mnorden81/RC-CRSF-Router-RP2350/README.md

# RC-CRSF-Router-RP2350 („CRSF-Router 8“)

CRSF-Verteiler für ELRS-Empfänger auf einem **Waveshare RP2350-Zero**. Der große Bruder des [RC-CRSF-Router-ESP32-S3](https://github.com/mnorden81/RC-CRSF-Router-ESP32-S3): gleiche Weiterleitungsregeln, gleiche Bedienung über das Lua-Menü, aber bis zu 7 statt 2 Ports und **kein WLAN**.

Zwei Versionen, ein Sketch (Auswahl oben in `pins.h`):

| Version | Ports | Pins am RP2350-Zero | Im Sender | Platine |
|---|---|---|---|---|
| **Router** | Eingang + 7 Ports | alle, auch die 5 Pads an der Unterkante | `CRSF-Router8@15` | [hardware/Router](hardware/Router/) |
| **Test** | Eingang + 6 Ports | nur die beiden seitlichen Stiftleisten | `CRSF-Router8 Test@15` | keine, nur für das Steckbrett |

> Stand: Firmware **v0.4.1** („Version 2“: Filter, Telemetrie-Bremse, Geräteliste; dazu gezielte Zustellung und Lua-Vorrang nach ELRS-Vorbild), kompiliert und mit Host-Tests geprüft, **noch nicht auf Hardware getestet**. Erster Hardwaretest am 05.11.2026 auf dem Steckbrett (v0.2.0, nur seitliche Stiftleisten): der Sender findet den Router als „CRSF-Router8@14“ neben dem S3-Router und zwei Sound-Minis. Die Router-Platine ist seit 11.11.2026 fertig geroutet (DRC ohne Fehler), aber noch nicht bestellt.

| Testaufbau | RP2350-Zero auf dem Steckbrett |
|---|---|
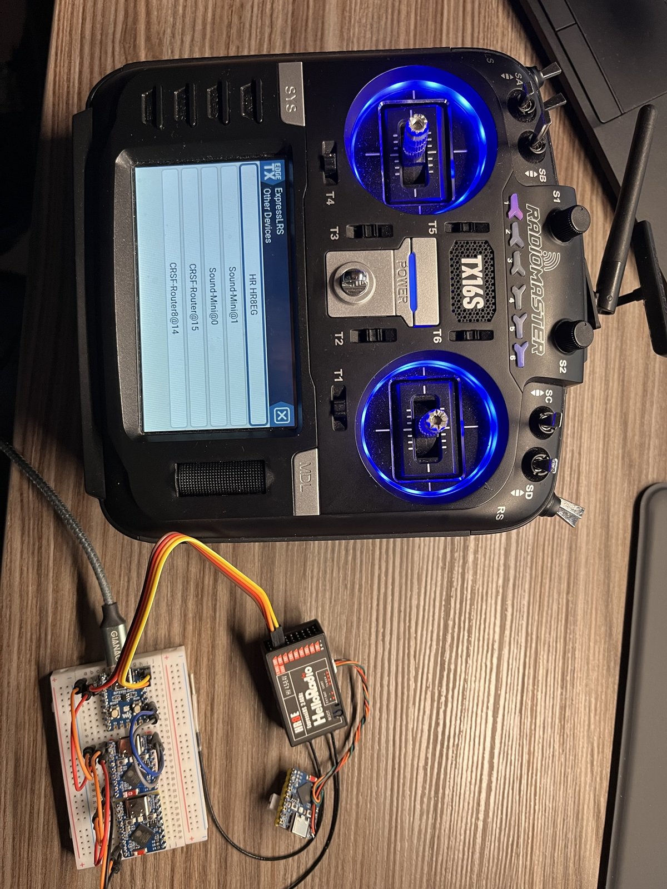
[picture p1: docs/bilder/testaufbau-sender.jpg]
Testaufbau: TX16S zeigt CRSF-Router8@14, CRSF-Router@15 und zwei Sound-Minis
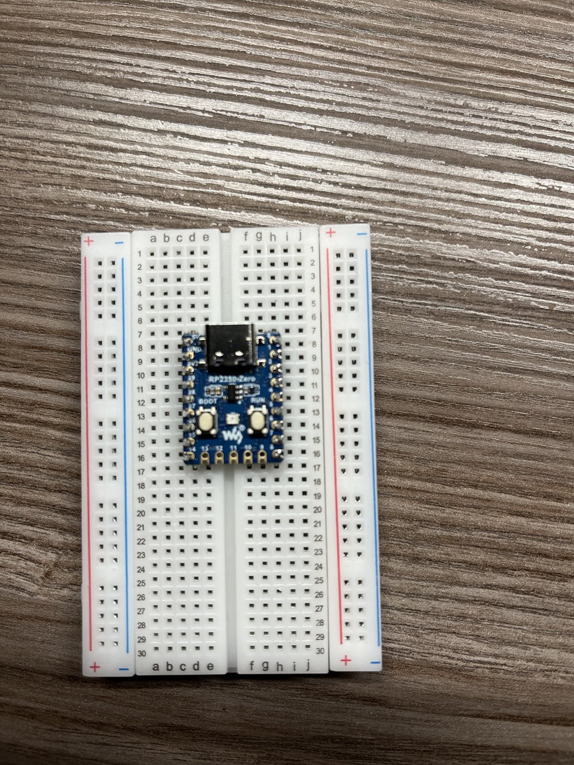
[picture p2: docs/bilder/rp2350-zero-steckbrett.jpg]
RP2350-Zero mit Stiftleisten auf dem Steckbrett
|  |  |

## Was er macht

Der Router hängt an einem freien CRSF-Port des Empfängers und verteilt CRSF auf bis zu 7 Geräte (Test-Version: 6): Multiswitche (auch die Ziege-One-Module), Soundmodule, Sensoren oder weitere Router.

- Vom Empfänger nach unten geht alles, außer Anfragen an die eigene Adresse. Anfragen an ein Gerät, dessen Port der Router schon kennt, gehen nur an diesen Port (ab v0.4.1).
- Von unten nach oben geht alles (Telemetrie, Lua-Antworten, DEVICE_INFO).
- Zwischen den Ports geht nichts, so entstehen keine Schleifen.
- Weitergegeben werden nur vollständige Frames mit gültiger CRC, unverändert.
- Jeder Port hat eine eigene Warteschlange und sendet nicht blockierend. Ein langsamer Port bremst die anderen nicht aus. Wird es eng, fällt zuerst ein alter RC-Frame weg, dann Telemetrie, Lua-Antworten zuletzt.

### Neu in v0.4.0 („Version 2“)

Die Ideen stammen aus dem Vergleich mit dem CRSF-Switch von Wilhelm Meier (wmucpp). Ohne Änderung im Lua-Menü verhält sich der Router genau wie v0.3.0.

| Funktion | Was sie macht | Wirkt |
|---|---|---|
| **Filter je Port** | RC-Kanäle (0x16/0x17) und LinkStats (0x14/0x1C/0x1D) nach unten je Port an oder aus. Ping, Lua und Schaltbefehle gehen immer durch. | sofort |
| **Telemetrie-Bremse je Port** | Telemetrie von unten nach oben: alle, höchstens 50/20/10/5/2/1 Frames pro Sekunde **je Sensor-Art**, oder aus. Bei RPM, Temperatur und Zellen zählt jede Quelle einzeln. DEVICE_INFO und Lua-Antworten gehen immer hoch. | sofort |
| **Geräteliste** | Der Router fragt 2 s und 6 s nach dem Start alle Ports per Ping ab und merkt sich die Antworten (bis 4 Geräte je Port, auch hinter einem weiteren Router). Lua-Ordner „Geräte“ zeigt sie, „Geräte suchen“ fragt neu ab. Antworten auf den eigenen Ping bleiben im Router. Die USB-Konsole listet jede Änderung. | sofort |

### Neu in v0.4.1 (Ideen aus dem ELRS-Empfänger)

Der ELRS-Empfänger hat seit Version 4.0 selbst einen kleinen CRSF-Router (Funkstrecke, CRSF-Port und auf ESP32-Empfängern ein zweiter UART). Drei seiner Regeln hat der Router übernommen. Im Lua-Menü ändert sich nichts, die Einstellungen bleiben erhalten.

| Funktion | Was sie macht |
|---|---|
| **Adress-Lernen + gezielte Zustellung** | Der Router merkt sich, hinter welchem Port welche Adresse sitzt (aus jedem Lua-, Ping- oder Befehls-Frame von unten und aus Heartbeats 0x0B). Lua-Anfragen und Schaltbefehle an ein bekanntes Gerät gehen nur noch an diesen Port. Unbekannte Ziele, Broadcasts (0x00) und 0xC8 gehen weiter an alle. Steckt man ein Gerät um, gilt der Port, von dem es sich zuletzt gemeldet hat. „Geräte suchen“ vergisst alle gelernten Adressen. |
| **Überschreiben statt Verwerfen** | Wartet noch ein Telemetrie-Frame gleicher Art (bei RPM/Temperatur/Zellen gleicher Quelle) vom selben Port, ersetzt der neue ihn an seinem Platz. So geht immer der neueste Wert hoch, die Schlange läuft nicht voll. |
| **Lua-Vorrang nach oben** | Ping-Antworten und Lua-Frames (0x28–0x2D) überholen wartende Telemetrie. Das Lua-Menü bleibt flüssig, auch wenn viele Module Telemetrie schicken. |

Die USB-Konsole zeigt dazu „gezielt“ und „ersetzt“ in der Statuszeile.

Zum Merken: Schaltet man an einem Port die RC-Kanäle ab, sieht ein Gerät dort (auch ein weiterer Router) kein RC-Signal mehr und geht in Failsafe.

## Status-LED (RGB-LED auf dem Board)

| LED | Bedeutung |
|---|---|
| grün langsam | RC-Signal in Ordnung |
| rot schnell | kein RC-Signal / Failsafe |
| gelb Doppelblitz | Adresskonflikt oder ein Port ließ sich nicht starten |

Sind Rot und Grün vertauscht, im Lua-Menü „LED Farbfolge“ auf **RGB** stellen.

## Lua-Menü (ELRS Lua / TBS Agent)

Ab v0.4.0 werden die Feld-IDs fortlaufend vergeben, sie haben sich gegenüber v0.3.0 verschoben (nur wichtig für eigene Skripte). Die Einstellungen aus v0.3.0 übernimmt der Router beim ersten Start.

| Eintrag | Werte |
|---|---|
| Version | z. B. „0.4.1 Router“ |
| Ordner **Ports (nach Neustart)** | |
| ↳ Port 1 … Port 7 | Aus, 57600, 115200, 400000, **420000**, 921600 |
| Ordner **Filter** → je Port ein Ordner | |
| ↳ RC-Kanaele runter | Aus, **Ein** |
| ↳ LinkStats runter | Aus, **Ein** |
| ↳ Telemetrie hoch | **Alle**, 50/s, 20/s, 10/s, 5/s, 2/s, 1/s, Aus |
| Ordner **Geraete** | |
| ↳ Geraete suchen | Nein, Jetzt |
| ↳ Port 1 … Port 7 | Anzeige, z. B. „Multiswitch@3, Sound@2“, „kein Geraet“, „aus“ |
| Modul Adresse | 0–15, Vorgabe **15** |
| Ordner **Telemetrie** | |
| ↳ Spannung senden | **Aus**, als RxBt, als Zellen |
| ↳ Spannung Korrektur | −0,5 … +0,5 V |
| ↳ Spannung | Anzeige |
| ↳ Temperatur senden | **Aus**, Ein |
| ↳ Chiptemperatur | Anzeige |
| Ordner **Status** | |
| ↳ Frames runter / hoch / Verworfen / Gefiltert / CRC-Fehler unten | Zähler |
| ↳ Adresskonflikt | ja/nein |
| ↳ Ports aktiv | je Port: Nummer = Gerät antwortet, `.` still, `-` aus, `!` Fehler |
| LED Farbfolge | **GRB**, RGB |
| Neustart | Nein, Jetzt |
| Geraetename | „CRSF-Router8“ bzw. „CRSF-Router8 Test“ |

Router: 65 Felder, Test: 59 Felder (Port 7 fehlt überall). Im Sender erscheint der Router als **CRSF-Router8@15** bzw. **CRSF-Router8 Test@15** (Name@Adresse).

## Brauche ich den Router überhaupt? (ELRS 4.x)

Ab ELRS 4.0 haben **ESP32-Empfänger** einen zweiten seriellen Port („Serial 2“, im ELRS-Lua oder WebUI auf „CRSF“ stellen; bei PWM-Empfängern lassen sich dafür PWM-Pins umstellen). Der Empfänger verteilt CRSF dann selbst zwischen beiden Ports.

- **Bis zu 2 Module** an einem ESP32-Empfänger: kein Router nötig.
- **Mehr als 2 Module**, **ESP8285-Empfänger** (nur ein CRSF-Port, z. B. EP1/EP2, RP1–RP3) oder Bedarf an Filtern, Telemetrie-Bremse und Geräteliste: Router verwenden.
- Mit Serial 2 kann der Router auch dort hängen, dann bleibt der erste Port für ein anderes Gerät frei.

## Mehrere Router

Jeder Router hat eine eigene WM-Adresse (0–15 → CRSF 0xC0 + Adresse). Mehrere Router im Modell (auch gemischt mit dem S3-Router) bekommen verschiedene Adressen, z. B. 15, 14, 13. Meldet ein Gerät weiter hinten dieselbe Adresse, blinkt die LED gelb. Router lassen sich verketten; mehr als 3 Router hintereinander sind nicht sinnvoll (je ca. 0,6 ms Verzögerung).

## Anschlüsse (Kurzfassung)

| Port | Router TX | Router RX | Test TX | Test RX | Art |
|---|---|---|---|---|---|
| Uplink (Empfänger) | GP0 | GP1 | GP0 | GP1 | Hardware-UART, fest 420000 Baud |
| Port 1 | GP2 | GP3 | GP2 | GP3 | PIO-UART |
| Port 2 | GP4 | GP5 | GP4 | GP5 | Hardware-UART |
| Port 3 | GP6 | GP7 | GP6 | GP7 | PIO-UART |
| Port 4 | GP8 | GP9 | GP8 | GP14 | PIO-UART |
| Port 5 | GP10 | GP11 | GP15 | GP27 | PIO-UART |
| Port 6 | GP12 | GP13 | GP28 | GP29 | PIO-UART |
| Port 7 | GP14 | GP15 | – | – | PIO-UART |
| Spannung | GP26 | | GP26 | | nur mit externem Teiler 33k/10k, auf der Platine nicht vorhanden |

Lage am Board (Oberseite, USB oben): rechte Leiste GP0–GP8, untere Kante GP9–GP13 (nur Lötpads), linke Leiste 5V, GND, 3V3, GP29, GP28, GP27, GP26, GP15, GP14. Die **Router**-Version braucht die Pads unten (5er-Stiftleiste einlöten), die **Test**-Version kommt mit den beiden seitlichen Leisten aus. Mehr als 8 UARTs (2 Hardware + 6 PIO) schafft der RP2350 nicht, deshalb sind 7 Ports das Maximum.

TX des Routers an RX des Geräts und umgekehrt, GND gemeinsam. Details und Schaltplan: [hardware/README.md](hardware/README.md).

## Firmware flashen

Der RP2350 hat kein WLAN, Updates gehen immer über USB. Am einfachsten ist Weg 1, dafür braucht man keine Software.

### Weg 1: Fertige Datei aus GitHub (ohne Arduino IDE)

1. Auf GitHub angemeldet sein (sonst gibt es keinen Download-Knopf).
2. In diesem Repo oben auf **Actions** klicken, links den Workflow **Firmware bauen** wählen.
3. Den obersten Lauf mit grünem Haken öffnen (Branch `main`).
4. Ganz unten unter **Artifacts** **crsf-router8-rp2350-Router** herunterladen (für das Steckbrett: **crsf-router8-rp2350-Test**) und die ZIP-Datei entpacken. Darin liegt `CRSF-Router8_Router.uf2` bzw. `CRSF-Router8_Test.uf2`.
   Steht dort nichts (Artefakte werden nach 90 Tagen gelöscht): rechts oben **Run workflow** → **Run workflow** klicken, nach ca. 3 Minuten ist ein neuer Lauf fertig.
5. Am RP2350-Zero die Taste **BOOT** gedrückt halten und dabei das USB-C-**Datenkabel** einstecken, dann loslassen.
6. Am PC erscheint ein neues Laufwerk **RP2350** (wie ein USB-Stick).
7. Die `.uf2`-Datei mit der Maus auf dieses Laufwerk ziehen. Das Laufwerk verschwindet, der Router startet von selbst neu. Fertig.

### Weg 2: Arduino IDE

**Einmalig einrichten**

1. Arduino IDE 2.x installieren (https://www.arduino.cc/en/software).
2. **Datei → Einstellungen → Zusätzliche Boardverwalter-URLs**:
   `https://github.com/earlephilhower/arduino-pico/releases/download/global/package_rp2040_index.json`
3. **Werkzeuge → Board → Boardverwalter**: „pico“ suchen, **Raspberry Pi Pico/RP2040/RP2350** (von Earle F. Philhower) in Version **6.3.2** installieren.
4. Weitere Bibliotheken sind nicht nötig.

**Flashen**

1. Repo herunterladen: oben auf GitHub **Code → Download ZIP**, entpacken (oder den vorhandenen Ordner nehmen).
2. **Datei → Öffnen** und `firmware/RC_CRSF_Router_RP2350/RC_CRSF_Router_RP2350.ino` wählen.
3. Version wählen: oben in `pins.h` steht `#define VARIANTE_ROUTER` (Vorgabe, für die Platine). Für die Test-Version (Steckbrett) diese Zeile mit `//` auskommentieren und bei `//#define VARIANTE_TEST` die `//` entfernen.
4. **Werkzeuge → Board → Raspberry Pi Pico/RP2040/RP2350 → Waveshare RP2350 Zero** wählen. Die übrigen Einstellungen unter Werkzeuge bleiben auf Standard.
5. Beim **allerersten Mal**: BOOT-Taste gedrückt halten, USB einstecken, loslassen. Unter **Werkzeuge → Port** „UF2 Board“ wählen.
   Ab dem zweiten Mal: einfach einstecken und unter **Werkzeuge → Port** den COM-Port wählen.
6. Auf den Pfeil **Hochladen** klicken. Der Router startet danach von selbst neu.

**Wenn das Hochladen nicht klappt** (kein Port oder „No drive to deploy“): USB abziehen, BOOT gedrückt halten, wieder einstecken und mit Port „UF2 Board“ erneut hochladen.

Der serielle Monitor (115200) zeigt alle 10 s eine Statuszeile.

## Aufbau des Repos

| Ordner | Inhalt |
|---|---|
| `firmware/RC_CRSF_Router_RP2350/` | Arduino-Sketch (siehe [firmware/README.md](firmware/README.md)) |
| `tests/` | Host-Tests des Routers (`sh tests/run_tests.sh`) |
| `hardware/Router/` | KiCad-Projekt der Router-Platine (geroutet, DRC ohne Fehler), nur THT-Bauteile, plus 3D-Modell `hardware/3d-modell.html` (siehe [hardware/README.md](hardware/README.md)) |
| `hardware/gehaeuse/` | 3D-Druck-Gehäuse (STL/STEP, CadQuery-Quelle, 3D-Vorschau), siehe [hardware/gehaeuse/README.md](hardware/gehaeuse/README.md) |
| `docs/` | Projektbeschreibung (DOCX), Fotos unter `docs/bilder/` |

## Herkunft

Die CRSF-Bibliothek stammt aus RC_Common (CRSF_ESP32 1.1.0), Basis ist [CRSF_ESP32 von Ziege-One](https://github.com/Ziege-One/CRSF_ESP32) (GPL-3.0).
