mnorden81/RC-CRSF-Router-RP2350/hardware/3d-modell.html

# CRSF-Router 8, Platine (THT)

Erstes 3D-Modell aus der KiCad-Platzierung, 38,4 × 25,5 mm, alles bedrahtet. Maße und Positionen stammen aus der Platine, die Bauteilkörper sind vereinfacht. Mit den Leiterbahnen der Oberseite (Stand 11.11.2026).

Ziehen = drehen · Rad/Pinch = zoomen · Rechts/zwei Finger = schieben

Ansicht SchrägObenSeite RP2350-Zero zeigen

## Stückliste

Ref | Wert | Bauform

## Aufbau

- Nur THT-Bauteile, von Hand lötbar: Elko 100 µF (Ø 5 mm), liegende Diode und Sicherung bedrahtet.
- Strom nur vom Empfänger über die Reihe U (Pin V), kein eigener BEC-Eingang, keine Spannungsmessung.
- Ohne Spannungsregler: der RP2350-Zero bekommt das BEC über die Diode D1 an seinen 5-V-Pin. Deshalb am Empfänger nur 5 bis 6 V, kein HV-BEC.
- Eine Sicherung (PTC 3 A) für alle Ports statt je Port eine, keine Lötbrücken und keine Serienwiderstände mehr. Übrig sind U1, C1, D1 und F1 statt über 30 Bauteile.
- So kompakt wie möglich: 38,4 × 25,5 mm, keine Befestigungslöcher, Beschriftung auf der Unterseite.
- RP2350-Zero direkt auf die Platine gelötet, ohne Buchsenleisten (Router: auch die 5 Pads unten, GP9–GP13).
