mnorden81/RC-CRSF-Router-RP2350/hardware/gehaeuse/Gehaeuse3D_Vorschau.html

# Gehäuse CRSF-Router 8

Entwurf 1 für die RP2350-Router-Platine (38,4 × 25,5 mm). Unterteil und Deckel zum Aufklipsen, keine Schrauben durch die Platine. Das Steckerfeld ist oben und rechts offen, damit die acht Dupont-Stecker greifbar bleiben. Maße aus der KiCad-Platine vom 11.11.

Außen42,2 × 29,3

Höhe20,3 mm

Platine38,4 × 25,5

Ziehen = drehen · Mausrad/zwei Finger = zoomen · rechte Maustaste = schieben

Zustand Zu Deckel ab Explosion

Ansicht Schräg USB-Seite Stecker-Seite Vorne Oben Unten

Zeigen Platine Stecker Deckel Gehäuse durchsichtig

## Öffnungen

Wo | Wofür | Größe
Links | USB-C zum Flashen, Platz für die Stecker-Umspritzung | 12,6 × 7,2
Rechts + Deckel | Steckerfeld U, 1–7 (8 × 4-pol. Dupont), oben und seitlich offen, Wand bis zur Oberkante der Stiftleisten | 11,4 × 21,2
Deckel | BOOT und RUN: Führungsrohr für Büroklammer oder Zahnstocher | Ø 2,0
Deckel | Lichtrohr über der RGB-LED | Ø 2,6
Deckel | Beschriftung T R V G und U, 1–7 am Steckerfeld | 0,5 tief

## Annahmen, bitte prüfen

- Höhe wird von F1 (PTC MF-RG300) und C1 (Elko 5 × 11) bestimmt. Ich habe F1 mit bis zu 12,5 mm über der Platine angenommen. Sitzt er niedriger oder legst du C1 und F1 flach, kann das Gehäuse um bis zu 7 mm flacher werden (Parameter OBEN).
- BOOT, RUN und LED habe ich aus deinem Steckbrett-Foto geschätzt: 15,3 mm vom USB-Ende, Tasten 4,8 mm links und rechts der Mitte.
- Stecker: 4-polige Dupont-Stecker (2,54 × 10,2 mm) sitzen dicht an dicht. Servo-Stecker (JR/Futaba) passen nur, wenn sie 4-polig sind.
- Halt: Die Platine liegt auf einer 0,8 mm breiten Kante rundum, der Deckel drückt mit vier Niederhaltern an freien Stellen von oben (zwischen Zero und Leisten, Ecken rechts). Keine Schraube, kein Kleben.
- Deckel klemmt mit Lippe und zwei Rastnasen an den Längsseiten. Sitzt er zu stramm, TOL von 0,15 auf 0,2 erhöhen.

## Drucken und Montieren

- Material PLA oder PETG, 0,2 mm Schicht (für die Schrift 0,12 mm).
- Unterteil mit dem Boden aufs Bett, Deckel mit der Oberseite aufs Bett (STL schon gedreht). Keine Stützen nötig.
- Einbauen: Platine mit USB nach links einlegen, Deckel aufdrücken, Stecker von oben aufstecken.
- Im Modell: 2 Laschen mit 2,4-mm-Loch (M2 oder Kabelbinder) oder Klebeband unter den Boden.
- Wand, Boden, Deckel je 1,6 mm.

## Dateien

- Gehaeuse_Unterteil.stl / .step
- Gehaeuse_Deckel.stl / .step
- gehaeuse.py (Quelle, CadQuery, alle Maße als Parameter oben)

Kollisionsprüfung Platine, Bauteile und Stecker gegen Gehäuse: 0 mm³. Autor: PiperPilot.
