mnorden81/RC-CRSF-Router-RP2350/hardware/3d-modell-v2.html

# CRSF-Router 8, Platine Variante 2 (THT)

Erstes 3D-Modell aus der KiCad-Platzierung, 70 × 45 mm, alles bedrahtet. Maße und Positionen stammen aus der Platine, die Bauteilkörper sind vereinfacht. Noch ohne Leiterbahnen.

Ziehen = drehen · Rad/Pinch = zoomen · Rechts/zwei Finger = schieben

Version Router · 7 PortsTest · 6 Ports Ansicht SchrägObenSeite RP2350-Zero gesteckt

## Stückliste dieser Version

Ref | Wert | Bauform

## Was V2 anders macht

- Nur THT-Bauteile, von Hand lötbar: Elko, Kondensator, Widerstände und Dioden bedrahtet.
- Ohne Spannungsregler: der RP2350-Zero bekommt das BEC über die Diode D1 an seinen 5-V-Pin. Deshalb nur BEC mit 5 bis 6 V, kein HV-BEC.
- Eine Sicherung (PTC 3 A) für alle Ports statt je Port eine, keine Lötbrücken und keine Serienwiderstände mehr. Das sind 9 Bauteile statt über 30.
- BEC-Eingang J9 mit Suppressordiode P6KE15CA gegen Spannungsspitzen, Platine 70 × 45 mm mit 4 × M3.
- RP2350-Zero steckt in Buchsenleisten (Router: auch unten 5er-Buchse für GP9–GP13).
