mnorden81/RC-CRSF-Router-RP2350/hardware/gehaeuse/Gehaeuse_Deckel.step

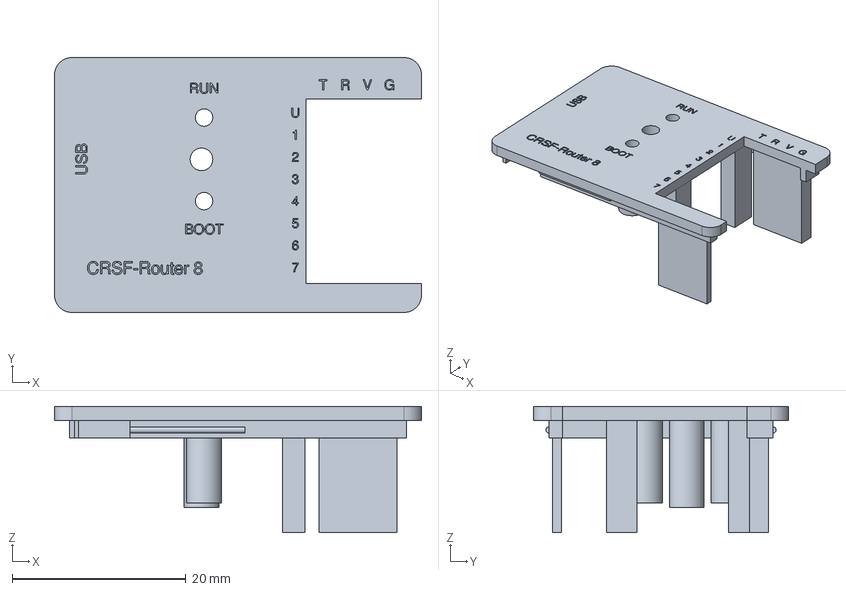
[picture p8: CAD file, 2026-11-12]
hardware/gehaeuse/Gehaeuse_Deckel.step
42.2 x 29.3 x 14.5 mm
