mnorden81/RC-CRSF-Router-RP2350/hardware/gehaeuse/Gehaeuse_Unterteil.step

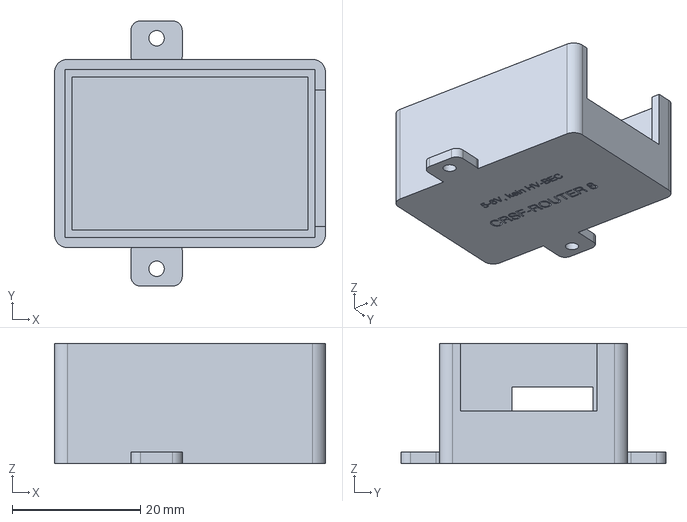
[picture p9: CAD file, 2026-11-12]
hardware/gehaeuse/Gehaeuse_Unterteil.step
42.2 x 41.3 x 18.7 mm
