mnorden81/RC-CRSF-Router-RP2350/(list of files, cad)

Other CAD files:
hardware/gehaeuse/Gehaeuse_Deckel.stl
hardware/gehaeuse/Gehaeuse_Unterteil.stl
