mnorden81/RC-CRSF-Router-RP2350/hardware/Router/RC-CRSF-Router-RP2350_Schaltplan.pdf

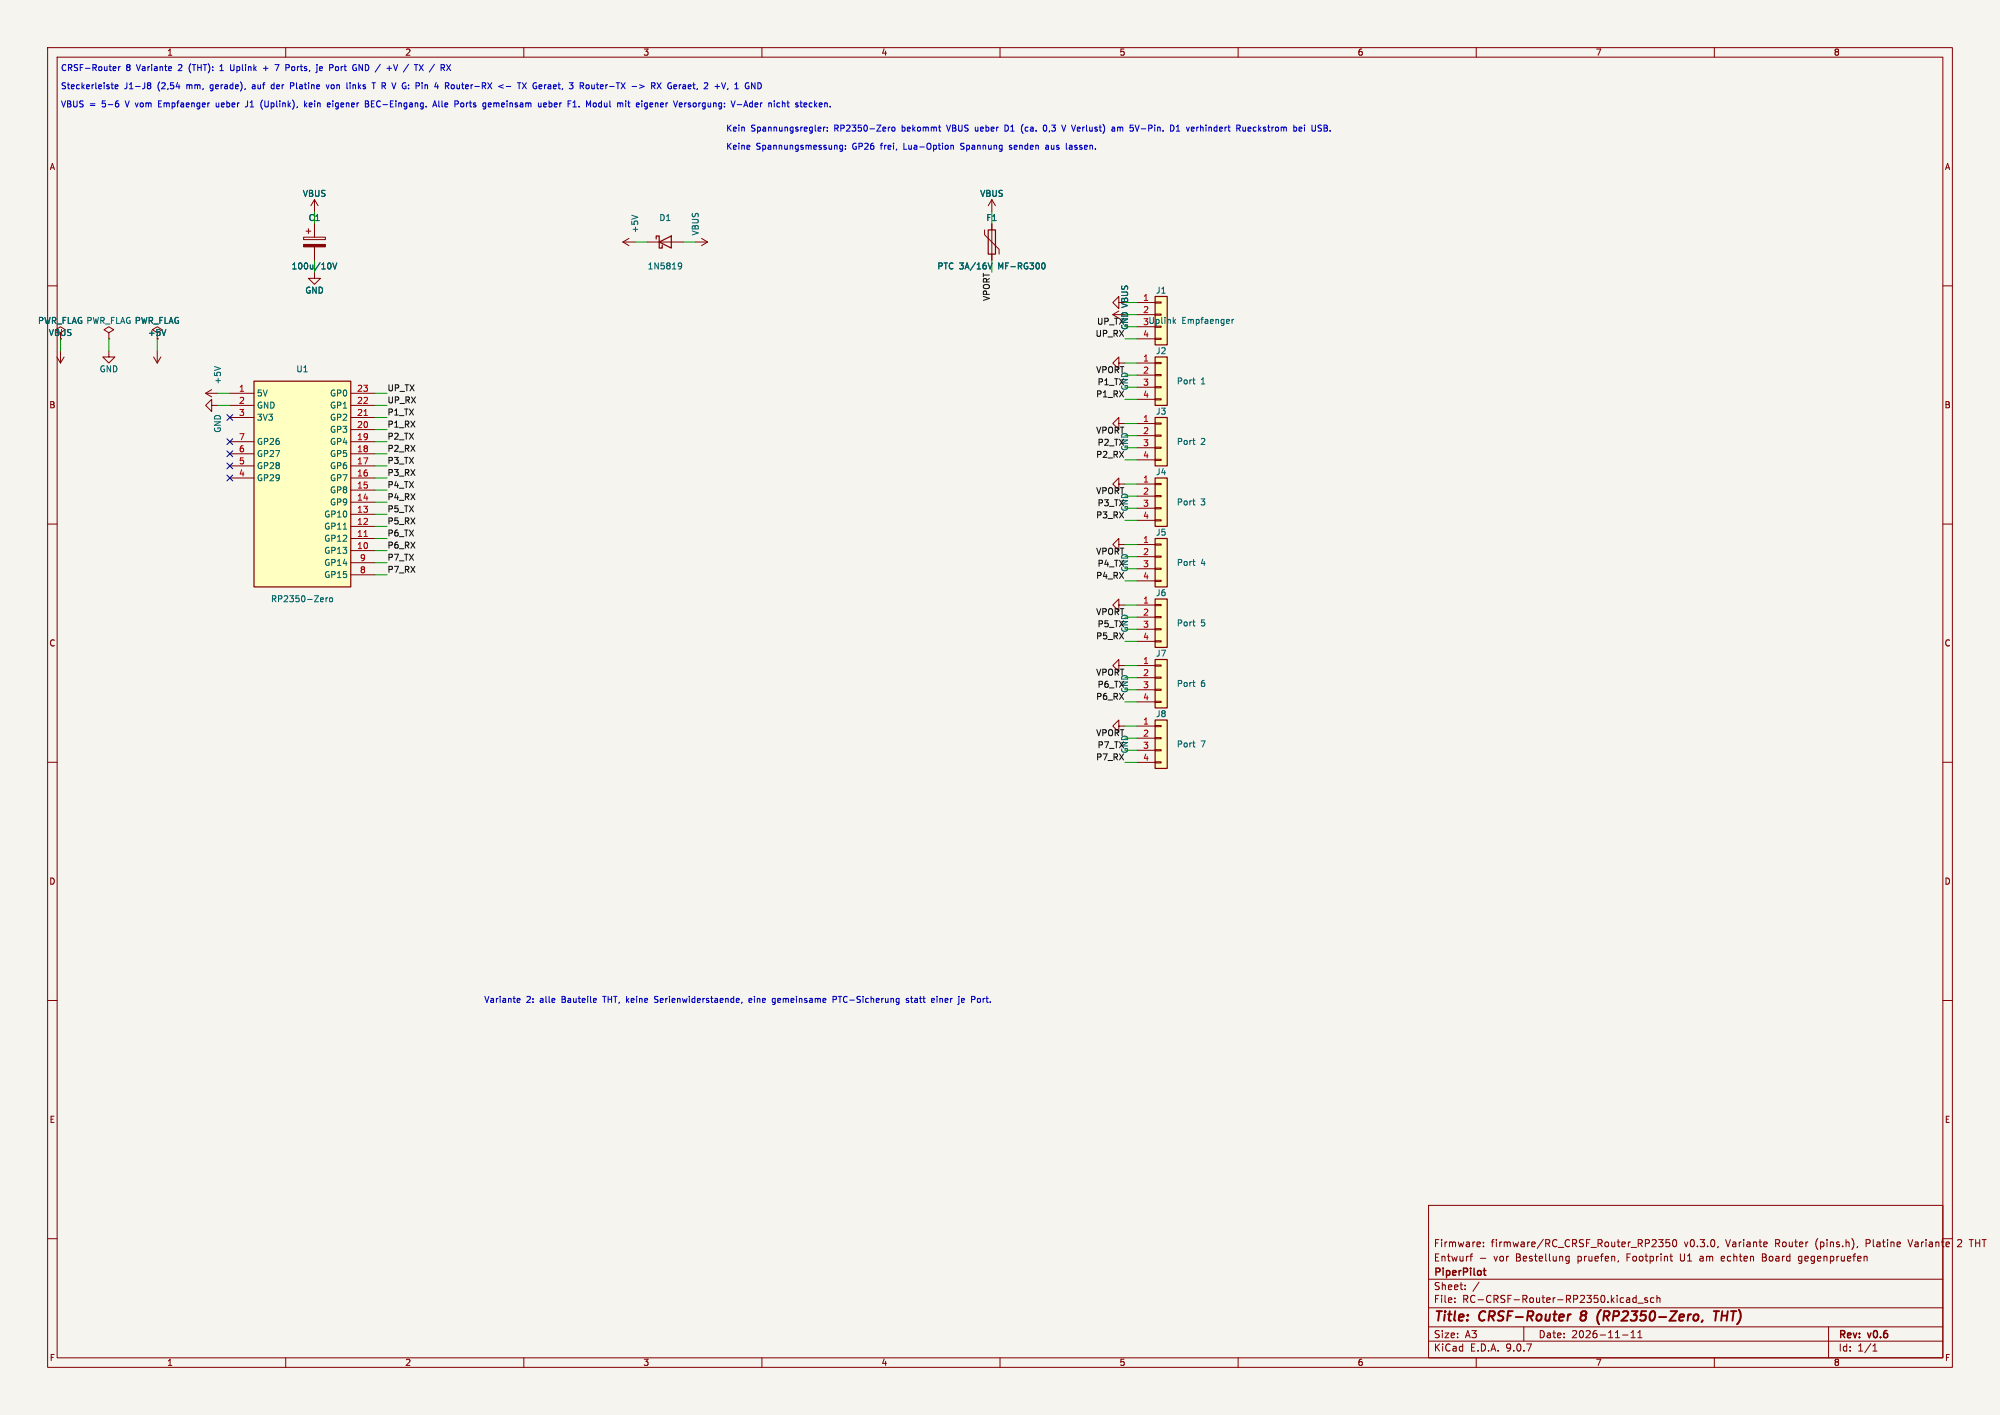
[picture p10: page 1]
