mnorden81/RC-CRSF-Router-RP2350/hardware/Router/RC-CRSF-Router-RP2350.kicad_pcb

## KiCad design hardware/Router/RC-CRSF-Router-RP2350.kicad_pcb (2026-11-11)

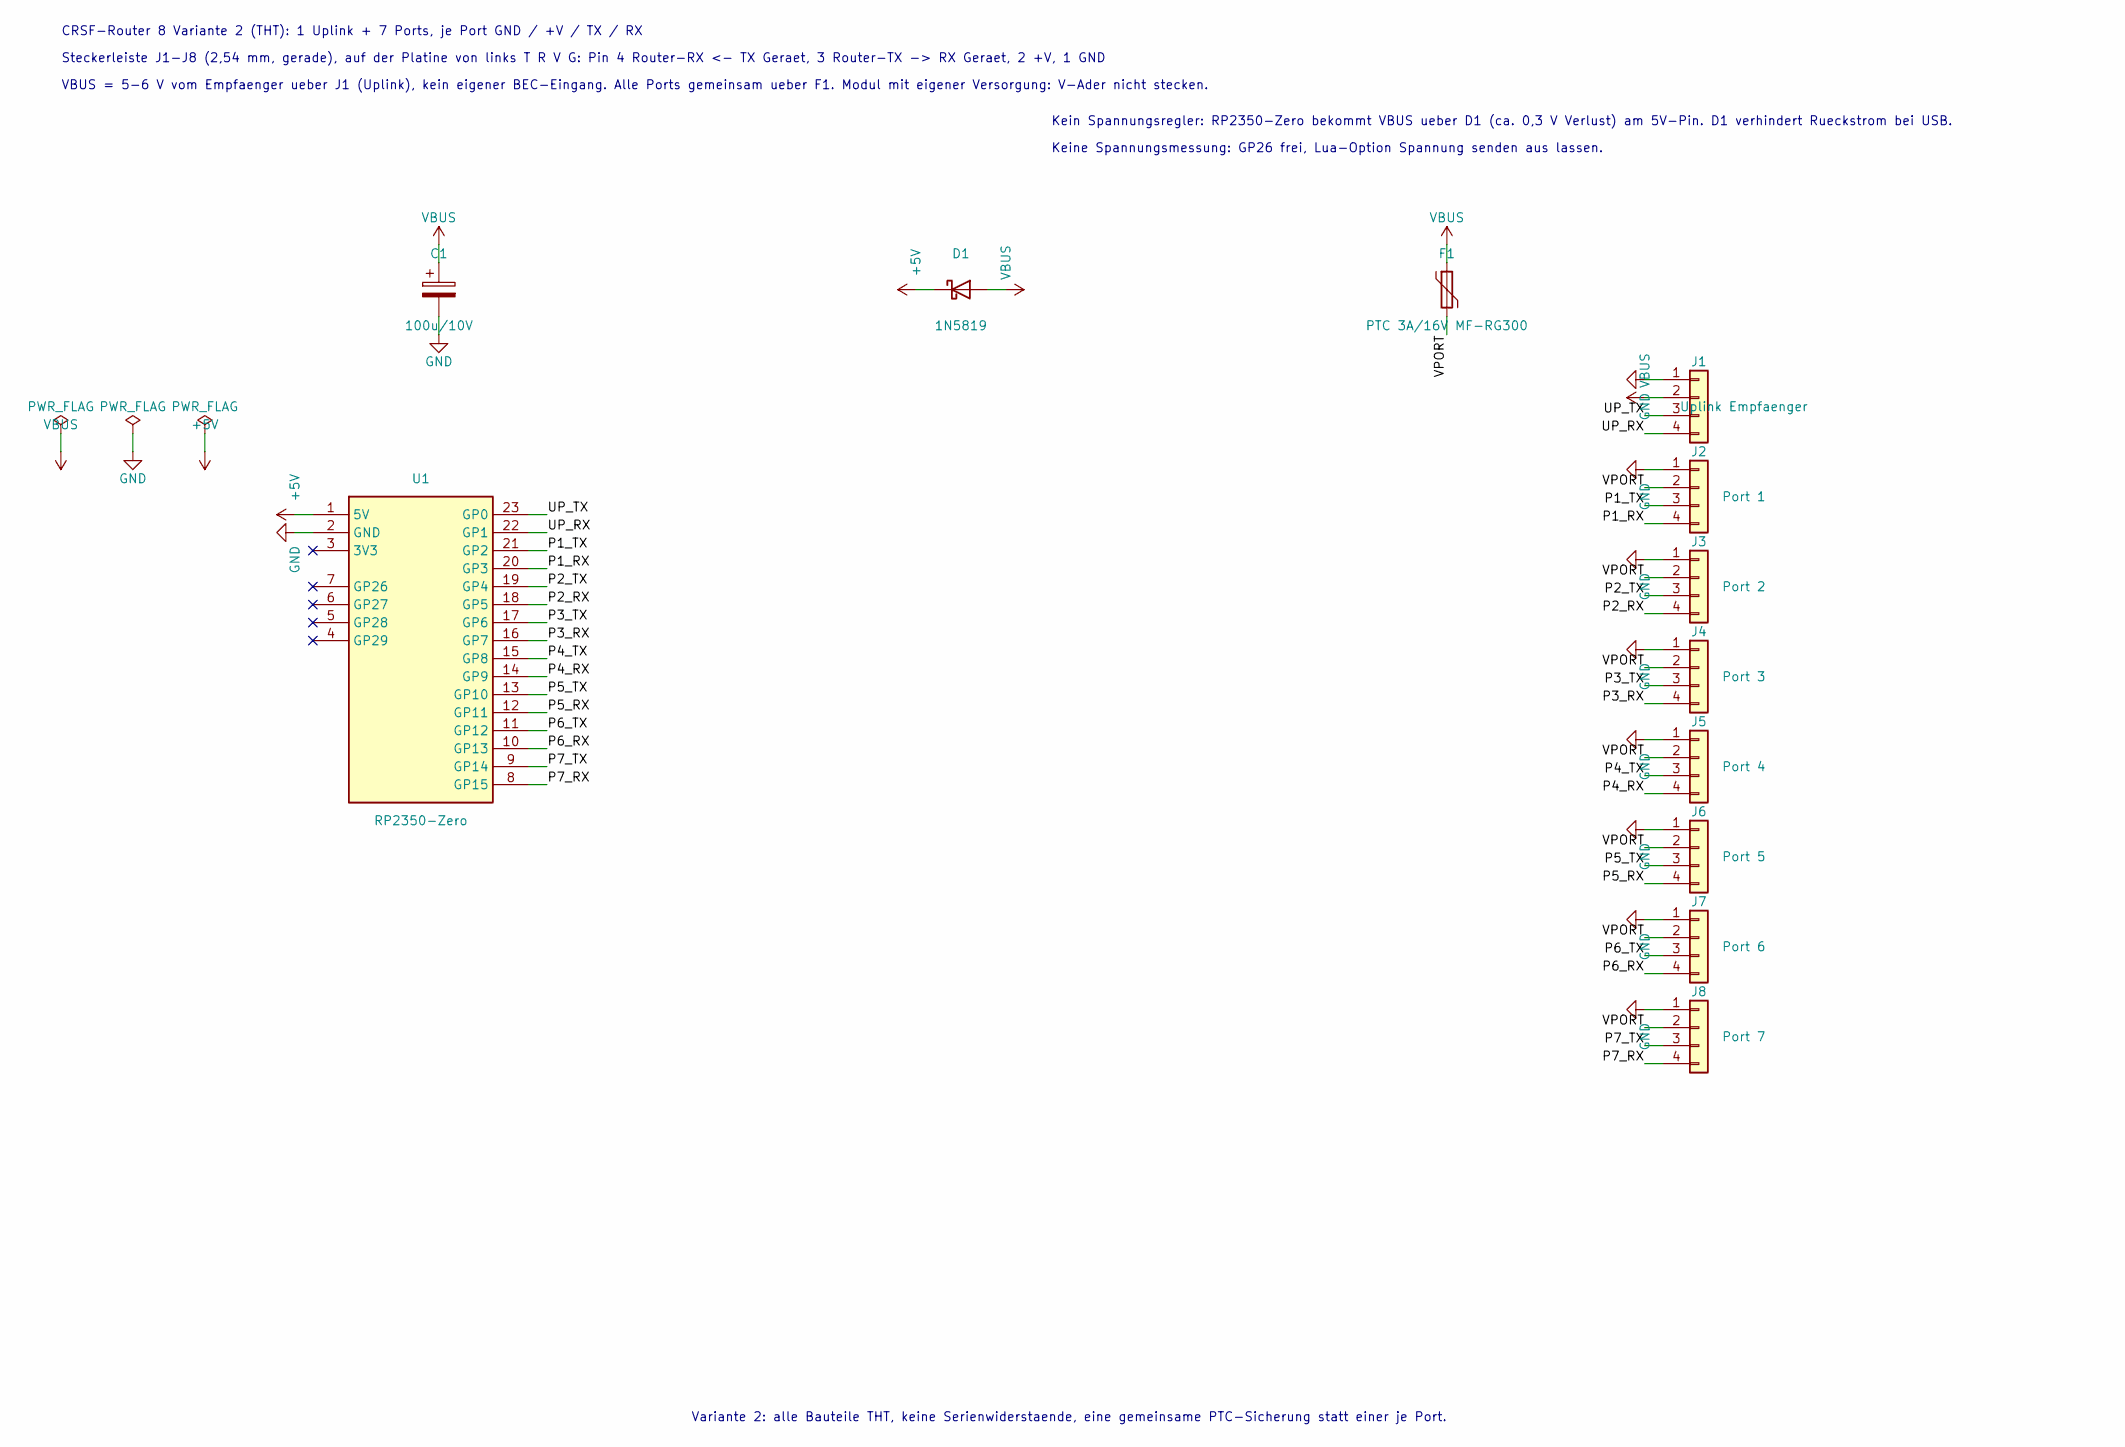
[picture p11: schematic RC-CRSF-Router-RP2350.kicad_sch, CRSF-Router 8 (RP2350-Zero, THT)]

Parts:
C1: 100u/10V; CP_Radial_D5.0mm_P2.00mm
D1: 1N5819; D_DO-41_SOD81_P7.62mm_Horizontal
F1: PTC 3A/16V MF-RG300; Fuse_Bourns_MF-RG300
J1: Uplink Empfaenger; PinHeader_1x04_Rail
J2: Port 1; PinHeader_1x04_Rail
J3: Port 2; PinHeader_1x04_Rail
J4: Port 3; PinHeader_1x04_Rail
J5: Port 4; PinHeader_1x04_Rail
J6: Port 5; PinHeader_1x04_Rail
J7: Port 6; PinHeader_1x04_Rail
J8: Port 7; PinHeader_1x04_Rail
U1: RP2350-Zero; RP2350-Zero_Socket

Connections:
+5V: D1.1 (K), U1.1 (5V)
/P1_RX: J2.4, U1.20 (GP3)
/P1_TX: J2.3, U1.21 (GP2)
/P2_RX: J3.4, U1.18 (GP5)
/P2_TX: J3.3, U1.19 (GP4)
/P3_RX: J4.4, U1.16 (GP7)
/P3_TX: J4.3, U1.17 (GP6)
/P4_RX: J5.4, U1.14 (GP9)
/P4_TX: J5.3, U1.15 (GP8)
/P5_RX: J6.4, U1.12 (GP11)
/P5_TX: J6.3, U1.13 (GP10)
/P6_RX: J7.4, U1.10 (GP13)
/P6_TX: J7.3, U1.11 (GP12)
/P7_RX: J8.4, U1.8 (GP15)
/P7_TX: J8.3, U1.9 (GP14)
/UP_RX: J1.4, U1.22 (GP1)
/UP_TX: J1.3, U1.23 (GP0)
/VPORT: F1.2, J2.2, J3.2, J4.2, J5.2, J6.2, J7.2, J8.2
GND: C1.2, J1.1, J2.1, J3.1, J4.1, J5.1, J6.1, J7.1, J8.1, U1.2 (GND)
VBUS: C1.1, D1.2 (A), F1.1, J1.2

Notes on the sheet:
Steckerleiste J1-J8 (2,54 mm, gerade), auf der Platine von links T R V G: Pin 4 Router-RX <- TX Geraet, 3 Router-TX -> RX Geraet, 2 +V, 1 GND
CRSF-Router 8 Variante 2 (THT): 1 Uplink + 7 Ports, je Port GND / +V / TX / RX
Variante 2: alle Bauteile THT, keine Serienwiderstaende, eine gemeinsame PTC-Sicherung statt einer je Port.
VBUS = 5-6 V vom Empfaenger ueber J1 (Uplink), kein eigener BEC-Eingang. Alle Ports gemeinsam ueber F1. Modul mit eigener Versorgung: V-Ader nicht stecken.
Kein Spannungsregler: RP2350-Zero bekommt VBUS ueber D1 (ca. 0,3 V Verlust) am 5V-Pin. D1 verhindert Rueckstrom bei USB.
Keine Spannungsmessung: GP26 frei, Lua-Option Spannung senden aus lassen.

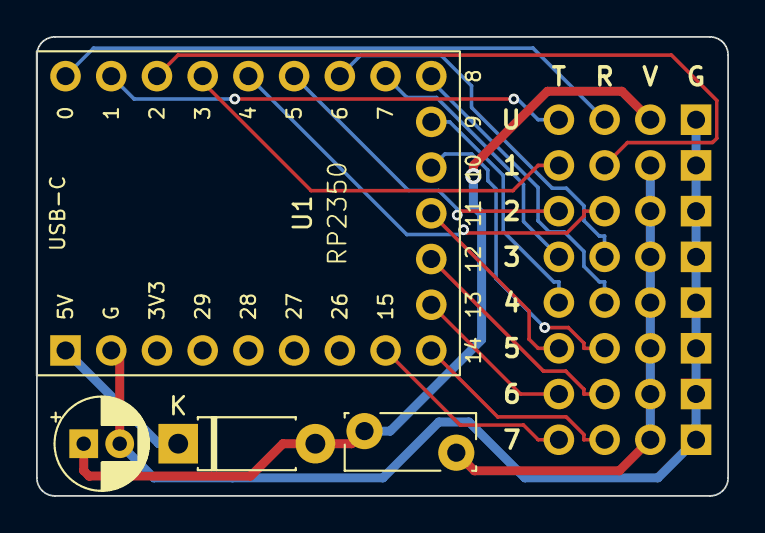
[picture p12: board hardware/Router/RC-CRSF-Router-RP2350.kicad_pcb from above]

Board: 2 copper layers, 38.4 x 25.5 mm, 12 parts (0 on the bottom side), 20 nets.
