mnorden81/RC-CRSF-Router-RP2350/hardware/RC-CRSF-Router-RP2350.kicad_pcb

## KiCad design hardware/RC-CRSF-Router-RP2350.kicad_pcb (2026-11-05)

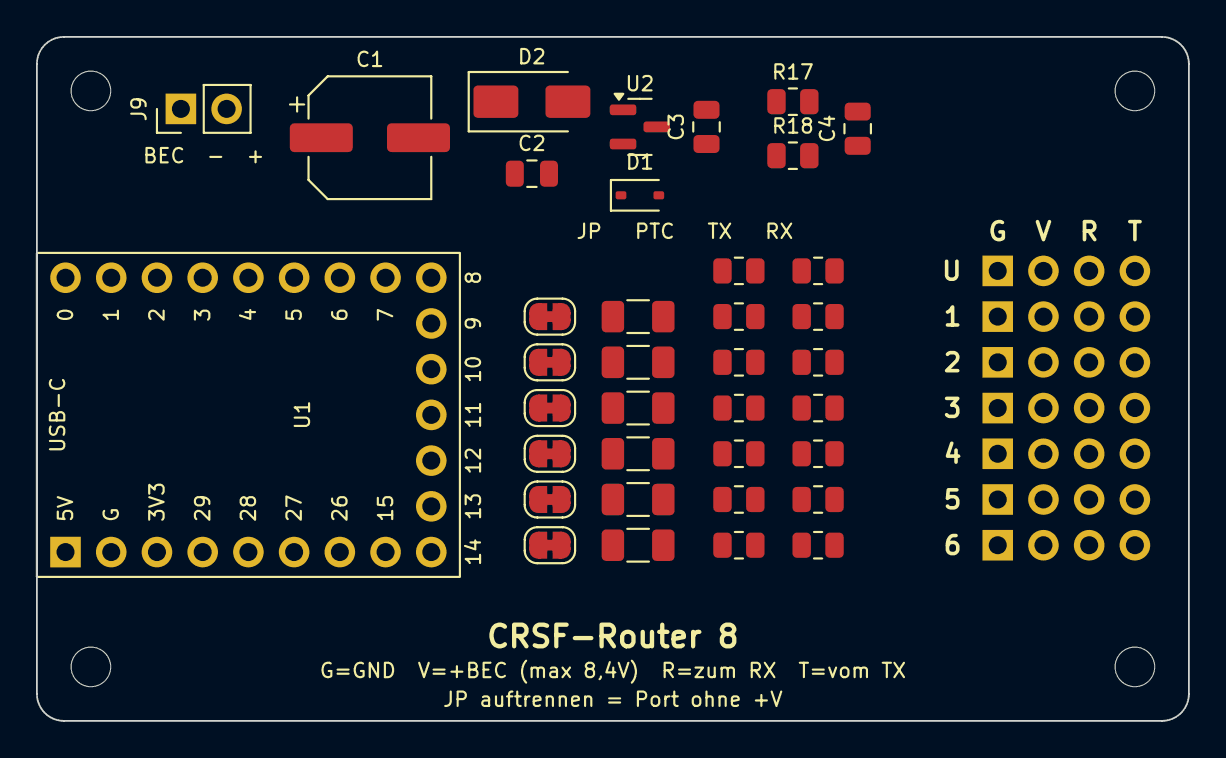
[picture p13: board hardware/RC-CRSF-Router-RP2350.kicad_pcb from above]

Board: 2 copper layers, 64.0 x 38.0 mm, 48 parts (0 on the bottom side), 45 nets, no tracks yet.

Parts:
C1: 220u/16V; CP_Elec_6.3x7.7
C2: 1u/25V; C_0805_2012Metric
C3: 1u; C_0805_2012Metric
C4: 100n; C_0805_2012Metric
D1: B5819WS; D_SOD-323
D2: SMAJ12CA; D_SMA
F1, F2, F3, F4, F5, F6: 0.5A/15V; Fuse_1206_3216Metric
H1, H2, H3, H4: M2; MountingHole_2.2mm_M2
J1: Uplink Empfaenger; PinHeader_1x04_Rail
J2: Port 1; PinHeader_1x04_Rail
J3: Port 2; PinHeader_1x04_Rail
J4: Port 3; PinHeader_1x04_Rail
J5: Port 4; PinHeader_1x04_Rail
J6: Port 5; PinHeader_1x04_Rail
J7: Port 6; PinHeader_1x04_Rail
J9: BEC IN; PinHeader_1x02_P2.54mm_Vertical
JP1, JP2, JP3, JP4, JP5, JP6: +V an; SolderJumper-2_P1.3mm_Bridged_RoundedPad1.0x1.5mm
R1, R2, R3, R4, R5, R6, R7, R8, R9, R10, R11, R12, R13, R14: 220; R_0805_2012Metric
R17: 33k; R_0805_2012Metric
R18: 10k; R_0805_2012Metric
U1: RP2350-Zero; RP2350-Zero_Socket
U2: MCP1703A-5002E/CB; SOT-23

Connections:
+5V: D1.1, U1.1 (5V)
/+5V_LDO: C3.1, D1.2, U2.2
/P1_RX: R4.1, U1.20 (GP3)
/P1_RXC: J2.4, R4.2
/P1_TX: R3.1, U1.21 (GP2)
/P1_TXC: J2.3, R3.2
/P1_V: F1.2, J2.2
/P1_VJ: F1.1, JP1.2
/P2_RX: R6.1, U1.18 (GP5)
/P2_RXC: J3.4, R6.2
/P2_TX: R5.1, U1.19 (GP4)
/P2_TXC: J3.3, R5.2
/P2_V: F2.2, J3.2
/P2_VJ: F2.1, JP2.2
/P3_RX: R8.1, U1.16 (GP7)
/P3_RXC: J4.4, R8.2
/P3_TX: R7.1, U1.17 (GP6)
/P3_TXC: J4.3, R7.2
/P3_V: F3.2, J4.2
/P3_VJ: F3.1, JP3.2
/P4_RX: R10.1, U1.9 (GP14)
/P4_RXC: J5.4, R10.2
/P4_TX: R9.1, U1.15 (GP8)
/P4_TXC: J5.3, R9.2
/P4_V: F4.2, J5.2
/P4_VJ: F4.1, JP4.2
/P5_RX: R12.1, U1.6 (GP27)
/P5_RXC: J6.4, R12.2
/P5_TX: R11.1, U1.8 (GP15)
/P5_TXC: J6.3, R11.2
/P5_V: F5.2, J6.2
/P5_VJ: F5.1, JP5.2
/P6_RX: R14.1, U1.4 (GP29)
/P6_RXC: J7.4, R14.2
/P6_TX: R13.1, U1.5 (GP28)
/P6_TXC: J7.3, R13.2
/P6_V: F6.2, J7.2
/P6_VJ: F6.1, JP6.2
/UP_RX: R2.1, U1.22 (GP1)
/UP_RXC: J1.4, R2.2
/UP_TX: R1.1, U1.23 (GP0)
/UP_TXC: J1.3, R1.2
/VSENSE: C4.1, R17.2, R18.1, U1.7 (GP26)
GND: C1.2, C2.2, C3.2, C4.2, D2.2, J1.1, J2.1, J3.1, J4.1, J5.1, J6.1, J7.1, J9.1, R18.2, U1.2 (GND), U2.1
VBUS: C1.1, C2.1, D2.1, J1.2, J9.2, JP1.1, JP2.1, JP3.1, JP4.1, JP5.1, JP6.1, R17.1, U2.3
