mnorden81/RC-CRSF-Router-RP2350/(commit log)

2026-11-04 Firmware v0.1.0: CRSF-Router 8 fuer RP2350-Zero (1 Uplink + 7 Ports)
    Lua-Menue, Status-LED, Spannung/Temperatur, Einstellungen im Flash,
    Host-Tests, GitHub Actions (UF2), README, Hardware-Doku, Projektbeschreibung.
    Claude-Session: https://claude.ai/code/session_0118D4qsYqDT4y3KFj5ZGQzg
2026-11-04 Hardware v0.1: KiCad-Projekt Verteilerplatine (Schaltplan, Platine platziert)
    RP2350-Zero gesteckt, Stiftleiste 8x4 (2,54 mm), BEC IN, 5-V-LDO bis 16 V,
    TVS, PTC und Loetbruecke je Port, 220-Ohm-Schutzwiderstaende,
    Spannungsteiler an GP26. Noch nicht geroutet.
    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
    [RC-CRSF-Router-RP2350.kicad_pcb, RC-CRSF-Router-RP2350.kicad_sch]
2026-11-05 v0.2.0: nur seitliche Stiftleisten, 1 Uplink + 6 Ports
    RP2350-Zero: nur die beiden seitlichen Stiftleisten werden benutzt,
    die Loetpads GP9-13 an der unteren Kante bleiben frei. Dort liegen 15
    freie GPIOs: 14 fuer 7 UARTs, GP26 misst weiter die Spannung.
    - Port 4 TX GP8 / RX GP14, Port 5 GP15/GP27, Port 6 GP28/GP29, Port 7 entfaellt
    - MR_MAX_DOWN 6, Lua-IDs ab Moduladresse um 1 nach vorn, Config-Version 2
    - KiCad: Schaltplan und Platine neu erzeugt (J1-J7, F1-F6, JP1-JP6, R1-R14)
    - README, Hardware-README, Firmware-README, Projektbeschreibung angepasst
    - Host-Tests auf 6 Ports: 40 Pruefungen, 0 Fehler
    Claude-Session: https://claude.ai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
    [RC-CRSF-Router-RP2350.kicad_pcb, RC-CRSF-Router-RP2350.kicad_sch]
2026-11-05 v0.3.0: zwei Versionen Router (7 Ports, alle Pins) und Test (6 Ports)
    - pins.h: VARIANTE_ROUTER (Vorgabe, Eingang + 7 Ports auf GP0-15, auch
    Loetpads GP9-13) oder VARIANTE_TEST (Eingang + 6 Ports, nur seitliche
    Stiftleisten wie v0.2.0). Lua-IDs je Variante (Router 1-26, Test 1-25),
    Geraetename CRSF-Router8 bzw. CRSF-Router8 Test.
    - MR_MAX_DOWN 7 (Platz), Config-Version 3
    - CI baut beide Varianten: CRSF-Router8_Router.uf2 / CRSF-Router8_Test.uf2
    - KiCad: hardware/Router (8 Steckerreihen, Buchse auf drei Seiten) und
    hardware/Test (7 Reihen), je eigener Schaltplan, Platine, PDF, Vorschau
    - Doku: README, Hardware-README, Firmware-README, Projektbeschreibung,
    Fotos vom ersten Test (CRSF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
    [RC-CRSF-Router-RP2350-Router.kicad_pcb, RC-CRSF-Router-RP2350-Router.kicad_sch, RC-CRSF-Router-RP2350-Test.kicad_pcb, RC-CRSF-Router-RP2350-Test.kicad_sch, RC-CRSF-Router-RP2350.kicad_sch]
2026-11-05 KiCad: Projektdateiname in .kicad_pro je Version
    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
2026-11-07 v0.4.0: Filter, Telemetrie-Bremse, Geraeteliste und Halbduplex je Port
    - Filter je Port: RC-Kanaele und LinkStats nach unten an/aus
    - Telemetrie nach oben je Port: alle, 50..1 Frames/s je Sensor-Art, aus
    - Geraeteliste: Ping an alle Ports beim Start und auf Abruf, DEVICE_INFO
    je Port gemerkt, Antworten an die eigene Adresse bleiben im Router
    - Halbduplex an den PIO-Ports (SerialPIOHD, ein Draht am TX-Pin)
    - halbe Frames verfallen nach 3 ms
    - Lua-Menue neu geordnet, Einstellungen aus v0.3.0 werden uebernommen
    - Host-Tests erweitert (74 Pruefungen)
    Claude-Session: https://claude.ai/code/session_0118D4qrspT4xKRGtYWd1BcD
2026-11-10 v0.4.0: Halbduplex wieder entfernt (Punkt 4)
    Auf Wunsch nur Filter, Telemetrie-Bremse und Geraeteliste. SerialPIOHD,
    Lua-Eintraege "Port n Leitung" und portLine in der Konfiguration
    entfernt. Der 3-ms-Timeout fuer halbe Frames bleibt fuer alle Ports.
    Lua: Router 65, Test 59 Felder. Host-Tests: 70 Pruefungen.
    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
2026-11-10 Hardware Variante 2: nur THT-Bauteile, vereinfacht (Router + Test) (#4)
    * Hardware Variante 2: nur THT-Bauteile, vereinfacht (Router + Test)
    - hardware/Router-V2 und hardware/Test-V2: Schaltplan, Platine 70x45 mm
    (platziert, nicht geroutet), PDF und Vorschaubild
    - eine gemeinsame PTC-Sicherung, keine Loetbruecken und Serienwiderstaende
    - erstes 3D-Modell hardware/3d-modell-v2.html
    - README und hardware/README um Variante 2 und Stueckliste ergaenzt
    * Variante 2 ohne Spannungsregler: BEC ueber D1 direkt an 5V-Pin
    U2, C2, C3 entfallen; BEC nur 5-6 V (kein HV). Pl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
    [RC-CRSF-Router-RP2350-Router-V2.kicad_pcb, RC-CRSF-Router-RP2350-Router-V2.kicad_sch, RC-CRSF-Router-RP2350-Test-V2.kicad_pcb, RC-CRSF-Router-RP2350-Test-V2.kicad_sch]
2026-11-11 Hardware: eine kompakte THT-Platine für den Router, Versorgung nur vom Empfänger (#6)
    * Variante 2: Versorgung nur vom Empfaenger, ohne BEC-Eingang und Spannungsmessung
    J9, D2, R1, R2, C4 entfallen, GP26 frei. Platine 62 x 45 mm.
    Schaltplan, Platinen, Vorschau, 3D-Modell und README angepasst.
    * Hardware: Variante 1 (SMD) entfernt, nur noch Router-V2 und Test-V2
    * Variante 2: C1 100 uF (D 5 mm), RP2350-Zero direkt aufgeloetet
    Co-Auth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
    [RC-CRSF-Router-RP2350-Router-V2.kicad_pcb, RC-CRSF-Router-RP2350-Router-V2.kicad_sch, RC-CRSF-Router-RP2350-Router.kicad_pcb, RC-CRSF-Router-RP2350-Router.kicad_sch, RC-CRSF-Router-RP2350-Test-V2.kicad_pcb, RC-CRSF-Router-RP2350-Test-V2.kicad_sch, RC-CRSF-Router-RP2350-Test.kicad_pcb, RC-CRSF-Router-RP2350-Test.kicad_sch]
2026-11-11 Router-Platine: Steckerleiste T R V G, TX/RX 0,2 mm (#7)
    * Variante 2: C1 100 uF (D 5 mm), RP2350-Zero direkt aufgeloetet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
    [RC-CRSF-Router-RP2350.kicad_pcb, RC-CRSF-Router-RP2350.kicad_sch]
2026-11-11 Router-Platine: lokales Routing von Martin (KiCad)
    [RC-CRSF-Router-RP2350.kicad_pcb, RC-CRSF-Router-RP2350.kicad_sch]
2026-11-11 Router-Platine: Beschreibung, Vorschaubilder und Schaltplan-PDF auf Stand nach dem Routing
2026-11-11 Doku: Platine geroutet, Projektbeschreibung auf aktuellem Stand (#8)
    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
2026-11-12 Gehaeuse fuer den 3D-Druck (Entwurf 1): Unterteil + Deckel, Steckerfeld offen
    Claude-Session: https://claude.ai/code/session_0118D4qqfHc73CDakVEX3nqn
    [Gehaeuse_Deckel.step, Gehaeuse_Deckel.stl, Gehaeuse_Unterteil.step, Gehaeuse_Unterteil.stl]
2026-11-12 v0.4.1: Ideen aus dem ELRS-Empfaenger uebernommen
    - Adress-Lernen (Extended-Frames + Heartbeat 0x0B) mit gezielter
    Zustellung nach unten
    - Telemetrie nach oben: neuer Wert ersetzt wartenden alten
    - Lua/Ping-Frames nach oben mit Vorrang, volle Schlange verwirft
    Lua zuletzt
    - Host-Tests ergaenzt, README mit Hinweis auf ELRS 4.x Serial 2
    Claude-Session: https://claude.ai/code/session_0118D4qs6f8FPyt6gz2KQt1D
2026-11-14 README: Anleitung zum Flashen
    Schritt-fuer-Schritt-Anleitung fuer Martin (Arduino IDE, fertige Datei
    aus GitHub Actions, Update per WLAN). Nur README, kein Code.
    Claude-Session: https://claude.ai/code/session_0118D4qqum127kn2FfD8dkis
